rasko65/Milivoj/firmware/Milivoj/secrets.example.h

// Kopiraj ovaj fajl u secrets.h i upiši prave vrednosti.
// secrets.h je u .gitignore, tako da lozinka i ključ nikad ne idu na GitHub.
#pragma once

#define WIFI_SSID      "tvoja-2.4GHz-mreza"
#define WIFI_PASSWORD  ""
#define WIFI_SSID2     ""                    // druga mreža (komšijina), prazno = ne koristi se
#define WIFI_PASSWORD2 ""
// #define WIFI_SSID3     ""                 // treća mreža (opciono), otkomentariši da se koristi
// #define WIFI_PASSWORD3 ""
#define AP_PASSWORD    ""                    // lozinka za "Milivoj-Setup" portal (min. 8 znakova)
#define TS_WRITE_KEY   "YOUR_WRITE_API_KEY"  // ThingSpeak > kanal > API Keys > Write API Key
