rasko65/Milivoj/(commit log)

2026-10-17 Milivojev bunar: ESP32 firmware and dashboard
2026-11-13 Firmware v2: WiFi setup portal, remote config, OTA updates
    Secrets now live in NVS (seeded by the cable-flashed build), so the
    public OTA firmware.bin carries no passwords or keys.
